andystopford/GPS_Tracker/Case/case_LiPo.dxf

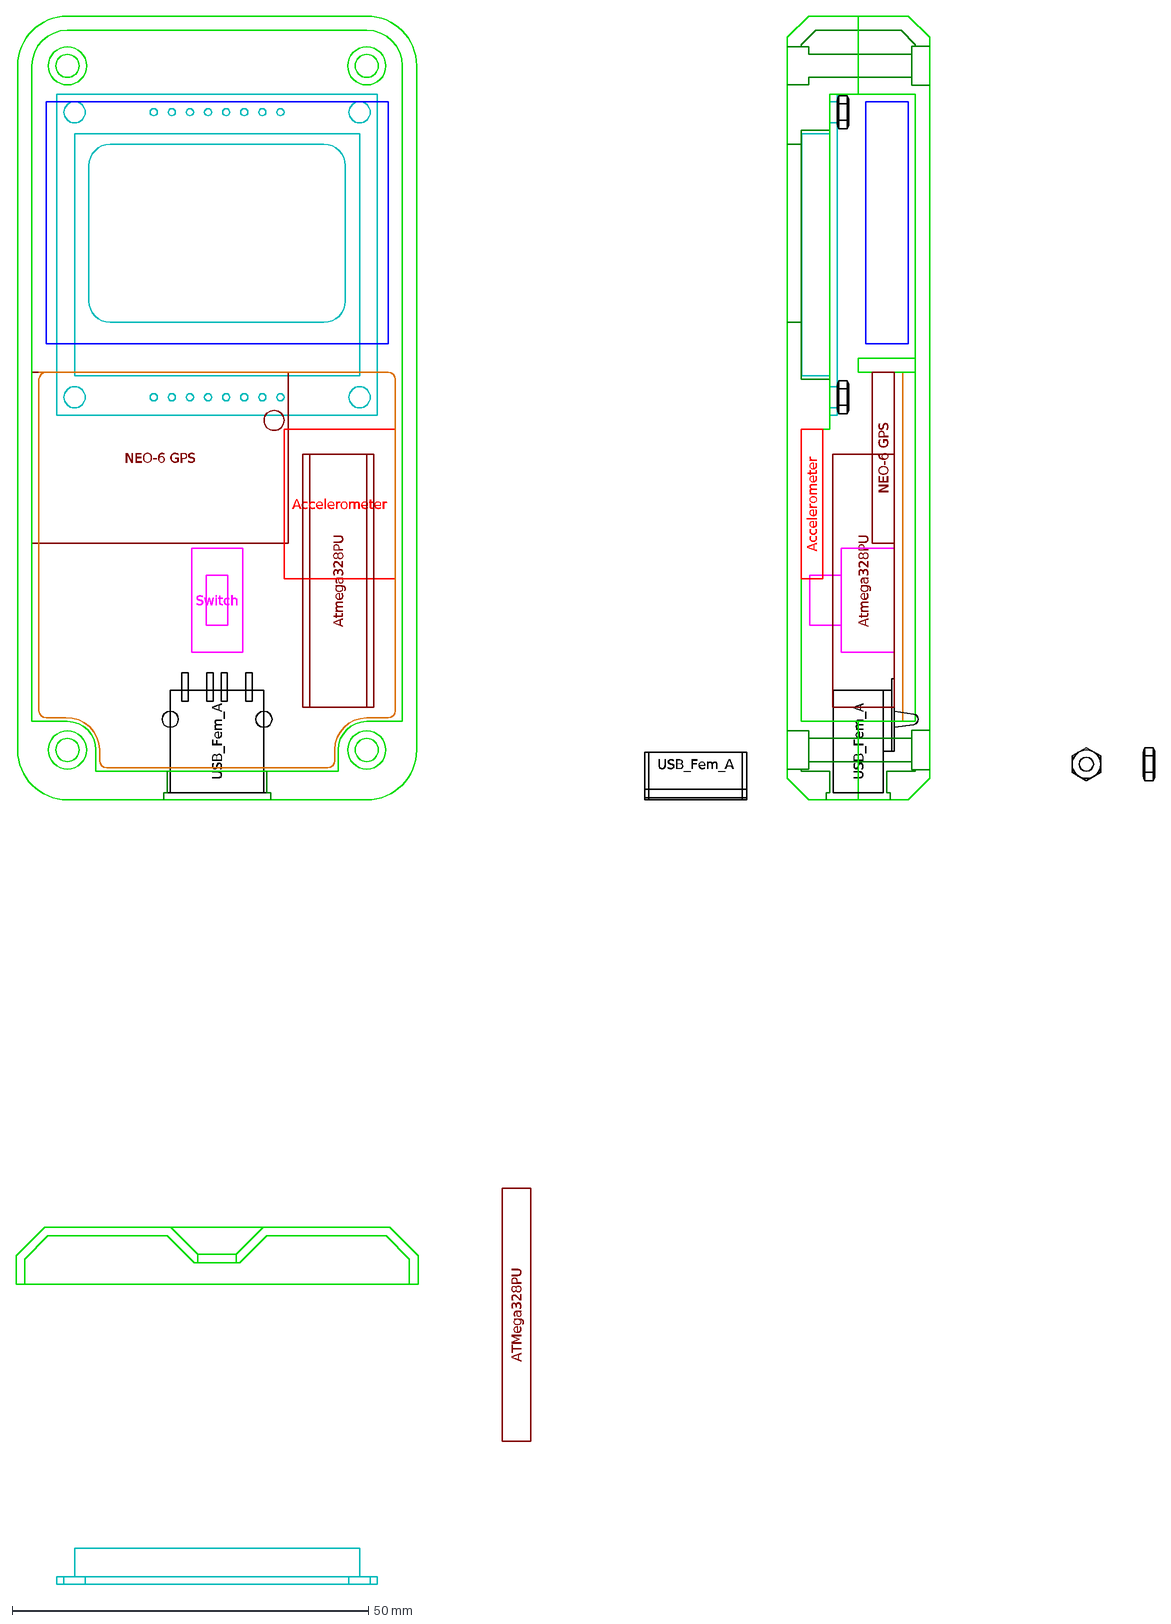
[picture p1: CAD file, 2018-06-07]
Case/case_LiPo.dxf
Atmega328PU
NEO-6 GPS
Switch
Accelerometer
ATMega328PU
USB_Fem_A
