andystopford/GPS_Tracker/PCB/Footprint_dwgs/16-LGA_3.25x3.0.dxf

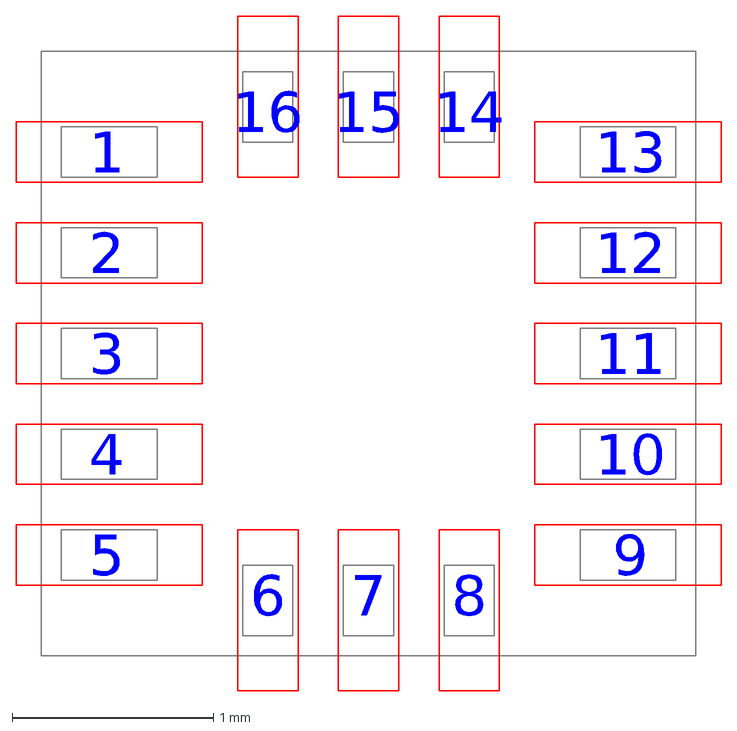
[picture p2: CAD file, 2018-06-07]
PCB/Footprint_dwgs/16-LGA_3.25x3.0.dxf
1
2
3
4
5
6
7
8
9
10
11
12
13
14
15
16
