andystopford/GPS_Tracker/PCB/PCB.dxf

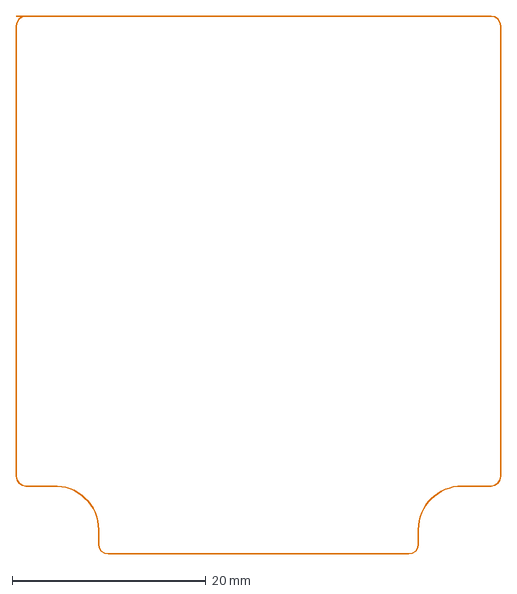
[picture p3: CAD file, 2018-06-07]
PCB/PCB.dxf
50.0 x 55.5 mm
