andystopford/GPS_Tracker/Case/GPS_tracker_support.stl

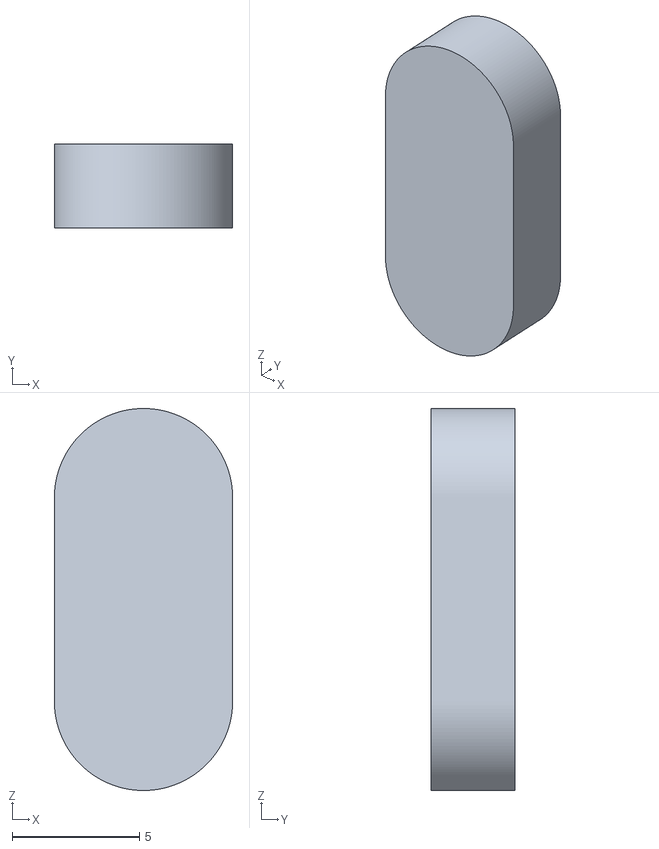
[picture p4: CAD file, 2018-06-07]
Case/GPS_tracker_support.stl
7.00 x 3.30 x 15.0
