andystopford/GPS_Tracker/Case/GPS_packing.stl

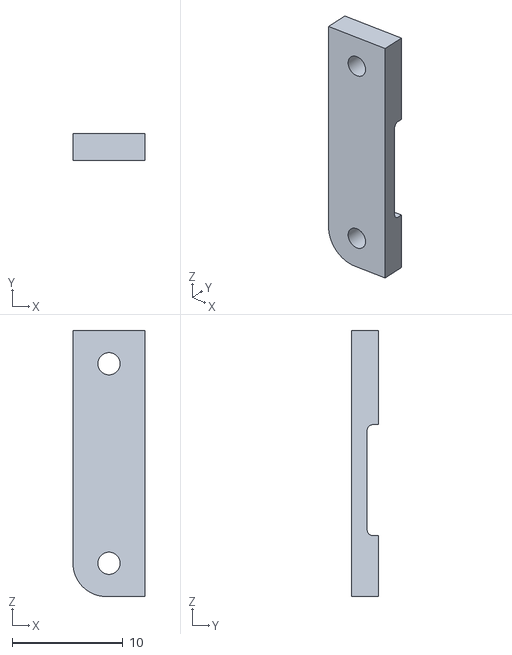
[picture p5: CAD file, 2018-06-07]
Case/GPS_packing.stl
6.50 x 2.40 x 24.0
