andystopford/GPS_Tracker/Case/case.dxf

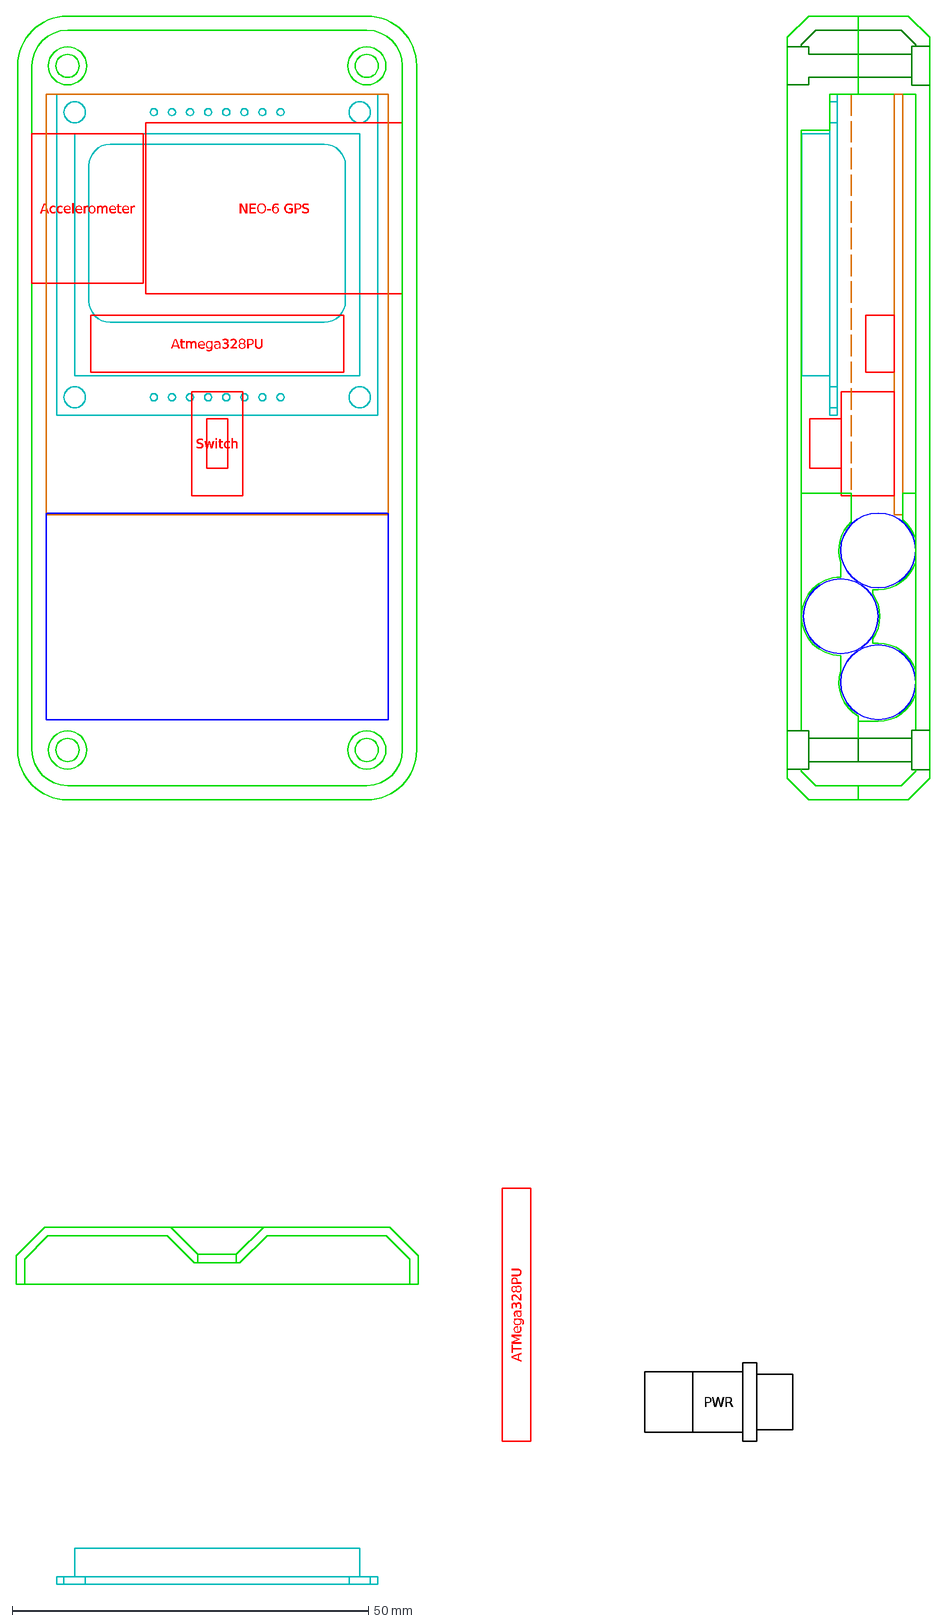
[picture p6: CAD file, 2018-06-07]
Case/case.dxf
Atmega328PU
NEO-6 GPS
Switch
Accelerometer
ATMega328PU
PWR
