andystopford/GPS_Tracker/Case/GPS_tracker_base.stl

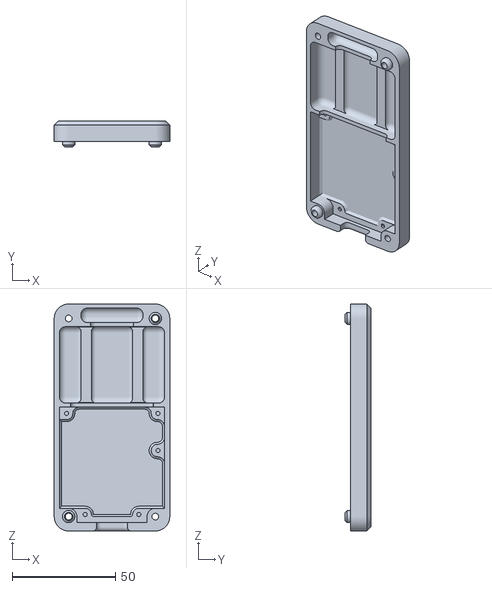
[picture p7: CAD file, 2018-06-07]
Case/GPS_tracker_base.stl
56.0 x 12.5 x 110.0
