andystopford/GPS_Tracker/Case/case_noLCD.dxf

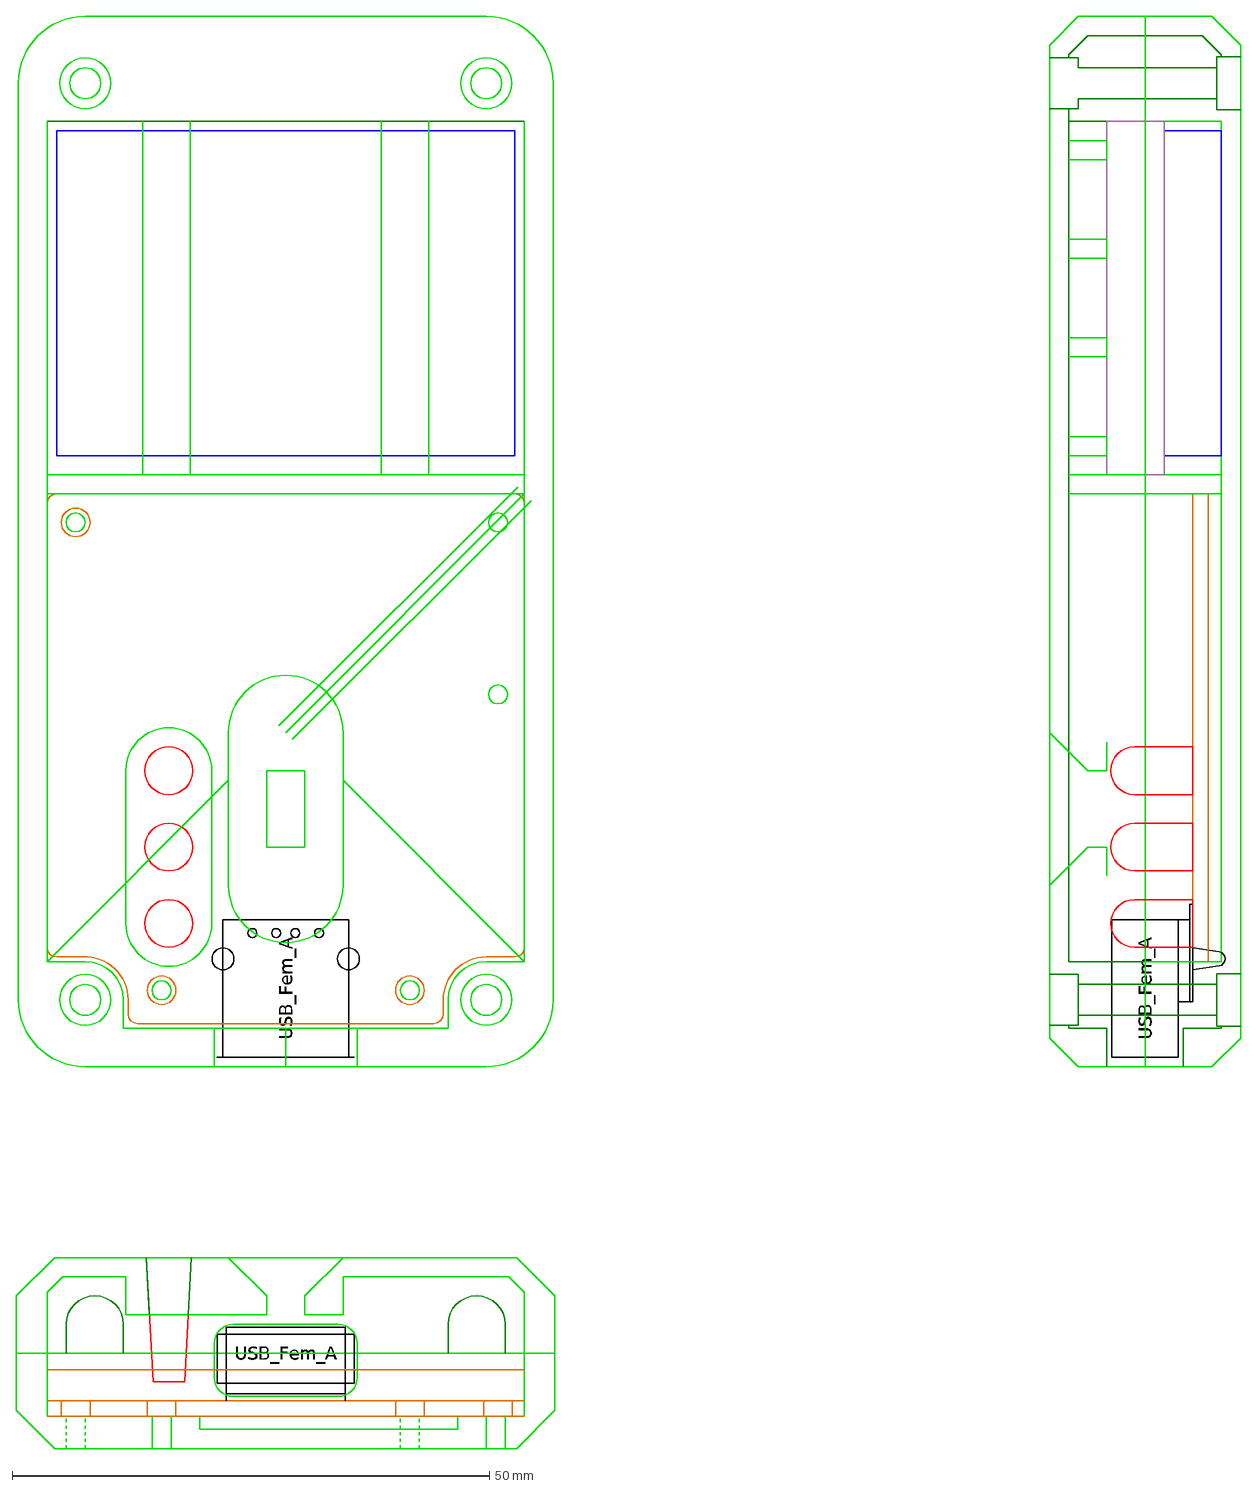
[picture p8: CAD file, 2018-06-07]
Case/case_noLCD.dxf
USB_Fem_A
