andystopford/GPS_Tracker/Case/GPS_tracker_top.stl

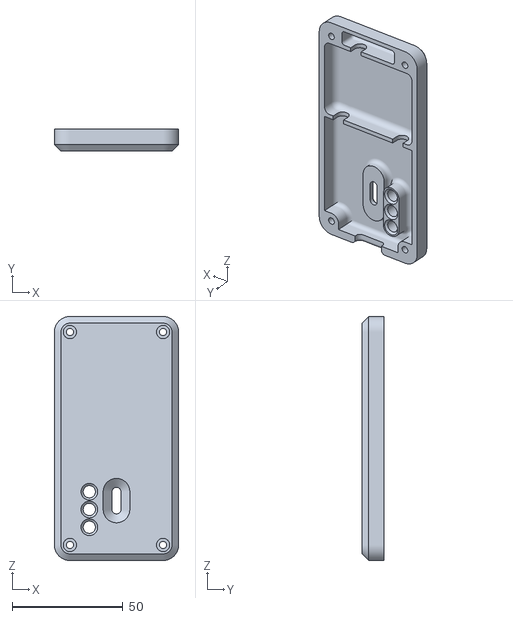
[picture p9: CAD file, 2018-02-08]
Case/GPS_tracker_top.stl
56.0 x 10.0 x 110.0
