andystopford/GPS_Tracker/(list of files, drawings)

Other design files:
PCB/AutoRouting/GPS_tracker_PCB.dsn
