andystopford/GPS_Tracker/PCB/GPS_tracker_PCB.kicad_pcb

## KiCad design PCB/GPS_tracker_PCB.kicad_pcb (2018-06-07)

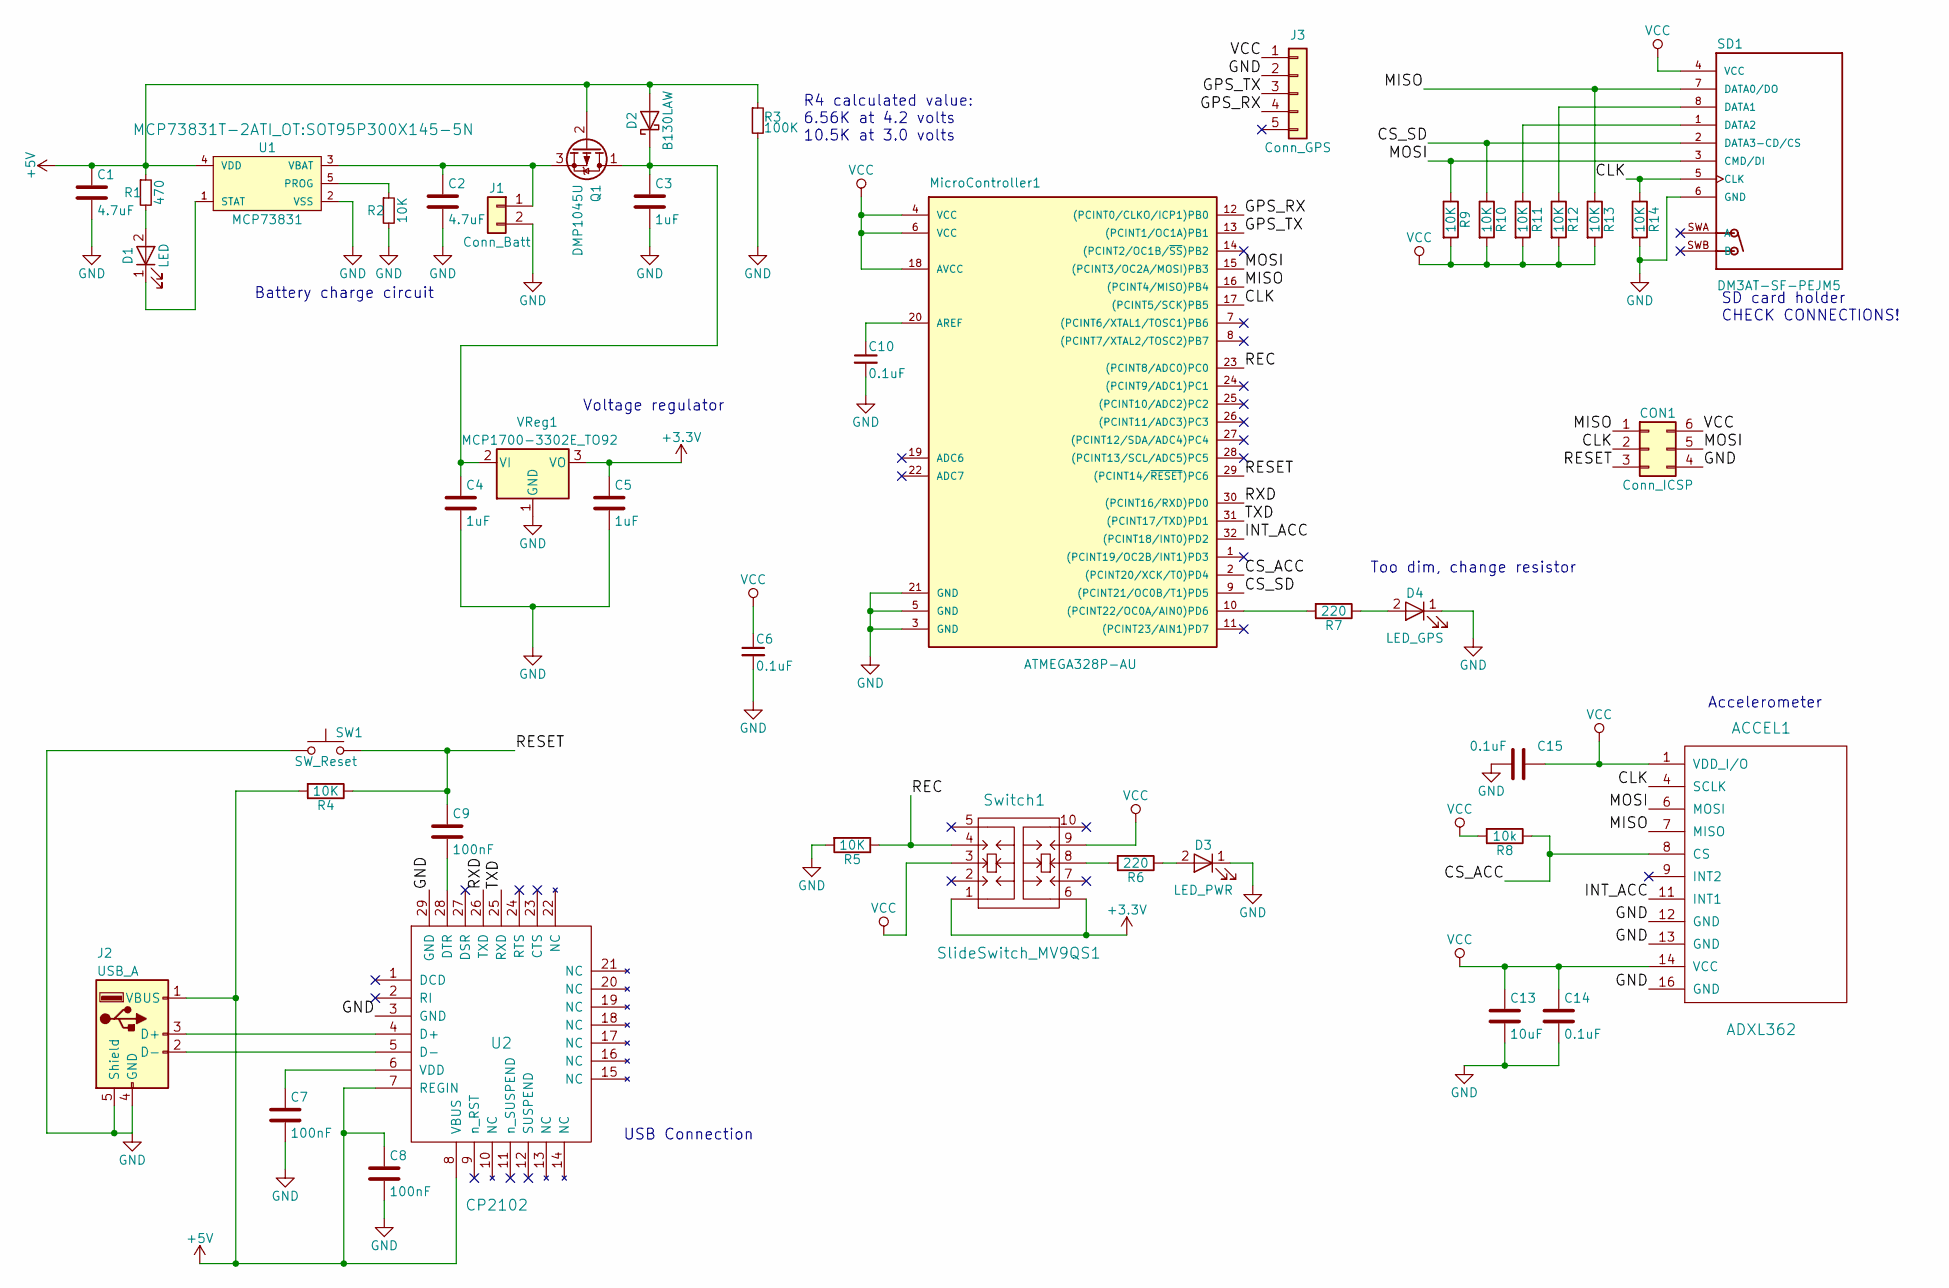
[picture p10: schematic GPS_tracker_PCB.sch]

Parts:
ACCEL1: ADXL362; LGA-16_3.25x3.00
C1, C2: 4.7uF; C_1206
C3, C4, C5: 1uF; C_1206
C6, C10, C14, C15: 0.1uF; C_1206
C7, C8, C9: 100nF; C_1206
C13: 10uF; C_1206
CON1: Conn_ICSP; Pin_Header_Straight_2x03_Pitch2.54mm
D1: LED; D_0603
D2: B130LAW; D_SOD-123
D3: LED_PWR; D_0603
D4: LED_GPS; D_0603
J1: Conn_Batt; Pin_Header_Straight_1x02_Pitch2.54mm
J2: USB_A
J3: Conn_GPS; Pin_Header_Straight_1x05_Pitch2.54mm
MicroController1: ATMEGA328P-AU; TQFP-32_7x7mm_Pitch0.8mm
Q1: DMP1045U
R1: 470; R_1206
R2, R4, R5, R9, R10, R11, R12, R13, R14: 10K; R_1206
R3: 100K; R_1206
R6, R7: 220; R_1206
R8: 10k; R_1206
SD1: DM3AT-SF-PEJM5; HRS_DM3AT-SF-PEJM5
SW1: SW_Reset; TactileButton_2Pin
Switch1: SlideSwitch_MV9QS1
U1: MCP73831; SOT95P300X145-5N
U2: CP2102; QFN-28-1EP_5x5mm_Pitch0.5mm
VReg1: MCP1700-3302E_TO92; TO-92_Inline_Wide

Connections:
+3V3: C5.1, Switch1.1, Switch1.6, VReg1.3 (VO)
+5V: C1.1, C8.1, D2.2 (A), J2.1 (VBUS), Q1.2 (G), R1.1, R3.1, R4.2, U1.4 (VDD), U2.7 (REGIN), U2.8 (VBUS)
/CLK: ACCEL1.4 (SCLK), CON1.2, MicroController1.17 ((PCINT5/SCK)PB5), R14.1, SD1.5 (CLK)
/CS_ACC: ACCEL1.8 (CS), MicroController1.2 ((PCINT20/XCK/T0)PD4), R8.1
/CS_SD: MicroController1.9 ((PCINT21/OC0B/T1)PD5), R10.1, SD1.2 (DATA3-CD/CS)
/GPS_RX: J3.4, MicroController1.12 ((PCINT0/CLKO/ICP1)PB0)
/GPS_TX: J3.3, MicroController1.13 ((PCINT1/OC1A)PB1)
/INT_ACC: ACCEL1.11 (INT1), MicroController1.32 ((PCINT18/INT0)PD2)
/MISO: ACCEL1.7 (MISO), CON1.1, MicroController1.16 ((PCINT4/MISO)PB4), R13.1, SD1.7 (DATA0/DO)
/MOSI: ACCEL1.6 (MOSI), CON1.5, MicroController1.15 ((PCINT3/OC2A/MOSI)PB3), R9.1, SD1.3 (CMD/DI)
/REC: MicroController1.23 ((PCINT8/ADC0)PC0), R5.1, Switch1.4
/RESET: C9.1, CON1.3, MicroController1.29 ((PCINT14/~RESET~)PC6), R4.1, SW1.2
/RXD: MicroController1.30 ((PCINT16/RXD)PD0), U2.26 (TXD)
/TXD: MicroController1.31 ((PCINT17/TXD)PD1), U2.25 (RXD)
GND: ACCEL1.12 (GND), ACCEL1.13 (GND), ACCEL1.16 (GND), C1.2, C2.2, C3.2, C4.2, C5.2, C6.2, C7.2, C8.2, C10.2, C13.2, C14.2, C15.2, CON1.4, D3.1 (K), D4.1 (K), J1.2, J2.4 (GND), J2.5 (Shield), J3.2, MicroController1.3 (GND), MicroController1.5 (GND), MicroController1.21 (GND), R2.2, R3.2, R5.2, R14.2, SD1.6 (GND), SW1.1, U1.2 (VSS), U2.3 (GND), U2.29 (GND), VReg1.1 (GND)
unnamed: C2.1, J1.1, Q1.3 (S), U1.3 (VBAT)
unnamed: C3.1, C4.1, D2.1 (K), Q1.1 (D), VReg1.2 (VI)
unnamed: C7.1, U2.6 (VDD)
unnamed: C9.2, U2.28 (DTR)
unnamed: C10.1, MicroController1.20 (AREF)
unnamed: D1.1 (K), U1.1 (STAT)
unnamed: D1.2 (A), R1.2
unnamed: D3.2 (A), R6.1
unnamed: D4.2 (A), R7.1
unnamed: J2.2 (D-), U2.5 (D-)
unnamed: J2.3 (D+), U2.4 (D+)
unnamed: MicroController1.10 ((PCINT22/OC0A/AIN0)PD6), R7.2
unnamed: R2.1, U1.5 (PROG)
unnamed: R6.2, Switch1.8
unnamed: R11.1, SD1.1 (DATA2)
unnamed: R12.1, SD1.8 (DATA1)
VCC: ACCEL1.1 (VDD_I/O), ACCEL1.14 (VCC), C6.1, C13.1, C14.1, C15.1, CON1.6, J3.1, MicroController1.4 (VCC), MicroController1.6 (VCC), MicroController1.18 (AVCC), R8.2, R9.2, R10.2, R11.2, R12.2, R13.2, SD1.4 (VCC), Switch1.3, Switch1.9

Notes on the sheet:
USB Connection
SD card holder CHECK CONNECTIONS!
Battery charge circuit
Voltage regulator
R4 calculated value: 6.56K at 4.2 volts 10.5K at 3.0 volts
Accelerometer
Too dim, change resistor

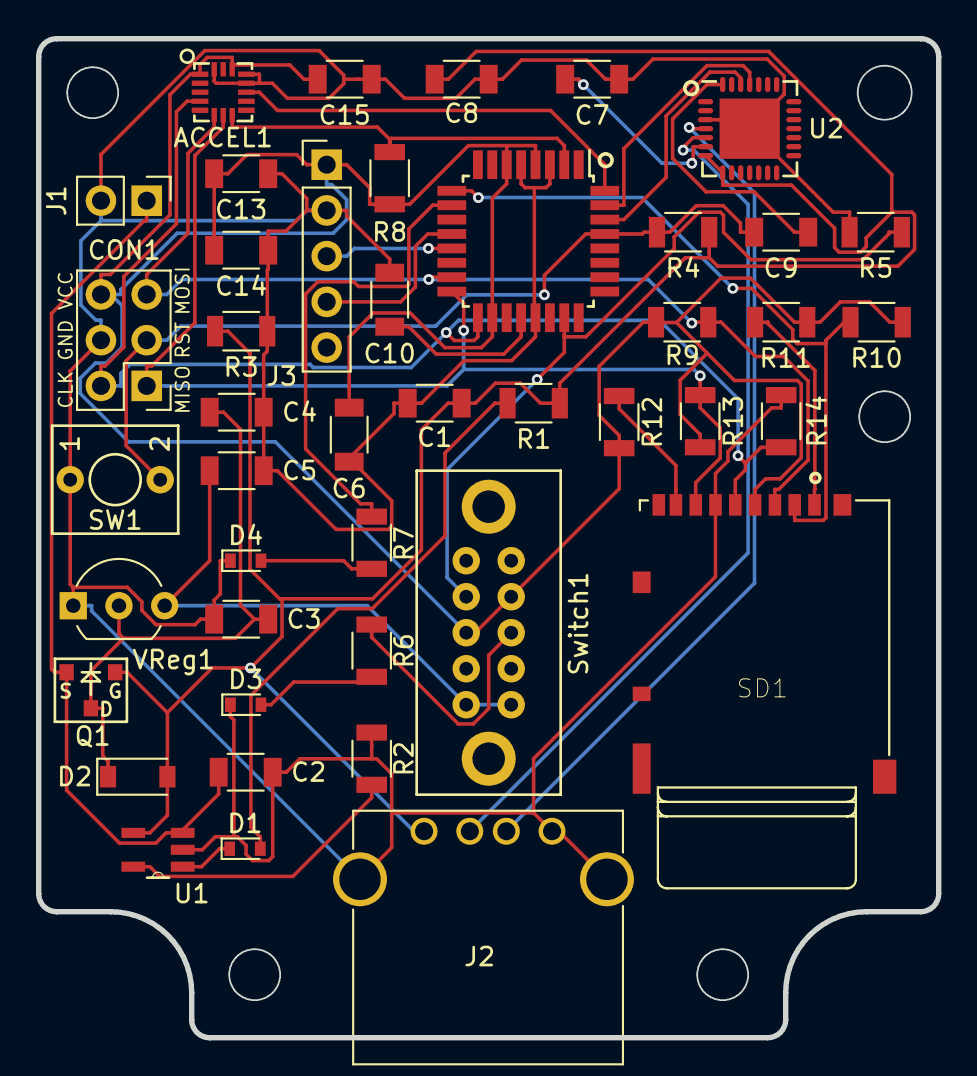
[picture p11: board GPS_tracker_PCB.kicad_pcb from above]

Board: 2 copper layers, 50.0 x 55.5 mm, 44 parts (0 on the bottom side), 32 nets.
