andystopford/GPS_Tracker/PCB/BAK.kicad_pcb

## KiCad design PCB/BAK.kicad_pcb (2018-06-07)

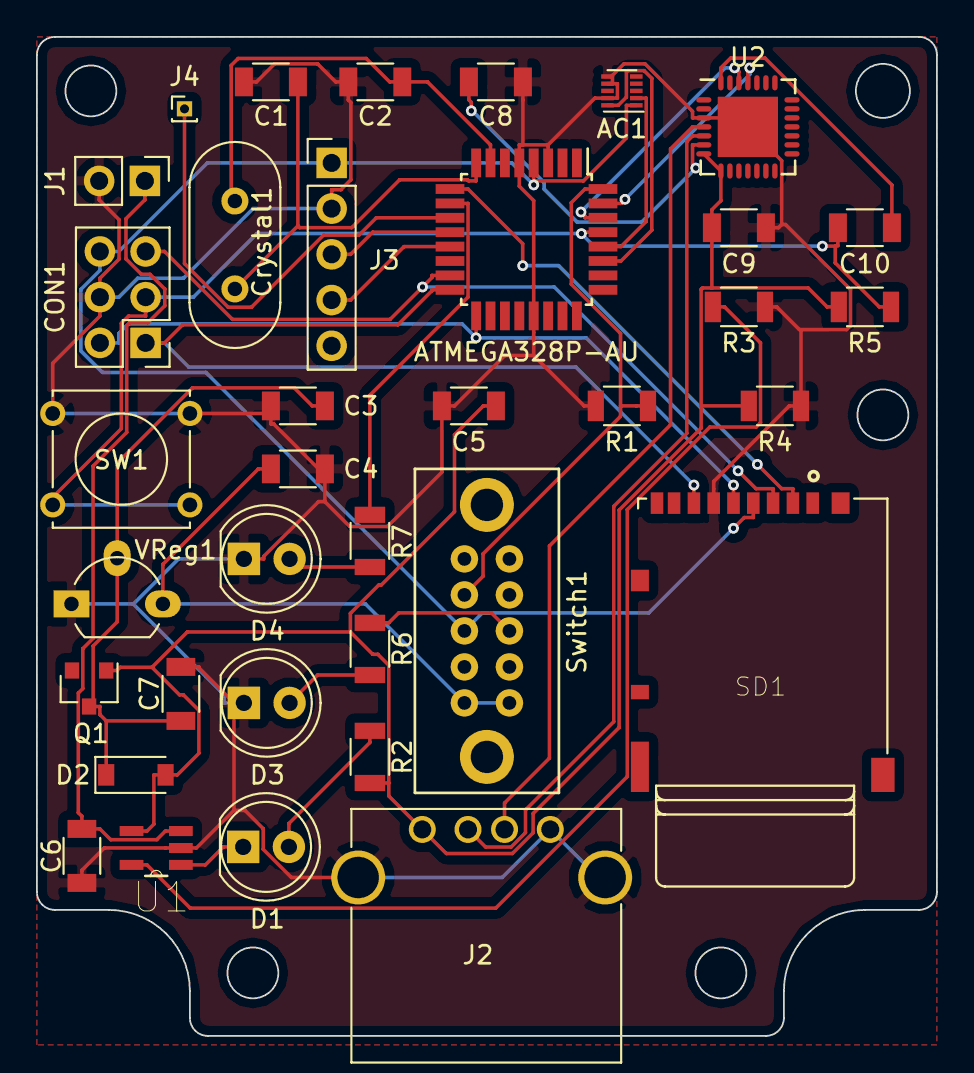
[picture p12: board BAK.kicad_pcb from above]

Board: 2 copper layers, 50.0 x 55.5 mm, 36 parts (0 on the bottom side), 32 nets.

Parts:
AC1: MMA8652FCR1; DFN-10_2x2mm_Pitch0.4mm
C1, C2, C3, C4: C; C_1206
C5, C6: 4uF; C_1206
C7: 1uF; C_1206
C8, C9, C10: 100nF; C_1206
CON1: Conn_ICSP; Pin_Header_Straight_2x03_Pitch2.54mm
Crystal1: 8MHz; Crystal_HC49-4H_Vertical
D1: LED; LED_D5.0mm
D2: B130LAW; D_SOD-123
D3: LED_PWR; LED_D5.0mm
D4: LED_GPS; LED_D5.0mm
J1: Conn_Batt; Pin_Header_Straight_1x02_Pitch2.54mm
J2: USB_A
J3: Conn_GPS; Pin_Header_Straight_1x05_Pitch2.54mm
J4: Conn_GPS_LED; Pin_Header_Straight_1x01_Pitch1.00mm
MicroController2: ATMEGA328P-AU; TQFP-32_7x7mm_Pitch0.8mm
Q1: DMP1045U; D_SOT-23_ANK
R1, R3, R5: 10K; R_1206
R2: 470; R_1206
R4: 100K; R_1206
R6, R7: 220; R_1206
SD1: DM3AT-SF-PEJM5; HRS_DM3AT-SF-PEJM5
SW1: SW_Reset; SW_Tactile_Straight_KSA0Axx1LFTR
Switch1: SlideSwitch_MV9QS1
U1: MCP73831; SOT95P300X145-5N
U2: CP2102; QFN-28-1EP_5x5mm_Pitch0.5mm
VReg1: MCP1700-3302E_TO92; TO-92_Molded_Wide_Oval

Connections:
+3V3: C4.1, Switch1.1, Switch1.6, VReg1.3
+5V: C5.1, C9.1, D2.2, J2.1, Q1.2, R2.1, R4.1, R5.2, U1.4, U2.7, U2.8
/CLK: CON1.2, MicroController2.17, SD1.5
/CS_SD: MicroController2.9, SD1.2
/GPS_RX: J3.4, MicroController2.13
/GPS_TX: J3.3, MicroController2.12
/MISO: CON1.1, MicroController2.16, SD1.7
/MOSI: CON1.5, MicroController2.15, SD1.3
/REC: MicroController2.32, R1.1, Switch1.4
/RESET: C10.1, CON1.3, MicroController2.29, R5.1, SW1.2
/RXD: MicroController2.30, U2.26
/SCL: AC1.2, MicroController2.28
/SDA: AC1.10, MicroController2.27
/TXD: MicroController2.31, U2.25
/VCC: AC1.1, CON1.6, J3.1, MicroController2.4, SD1.4, Switch1.3
GND: AC1.6, AC1.7, AC1.9, C1.2, C2.2, C3.2, C4.2, C5.2, C6.2, C7.2, C8.2, C9.2, CON1.4, D3.1, D4.1, J1.2, J2.4, J2.5, J3.2, MicroController2.3, MicroController2.5, MicroController2.21, R1.2, R3.2, R4.2, SD1.6, SW1.1, U1.2, U2.3, U2.29, VReg1.1
unnamed: C1.1, Crystal1.1, MicroController2.8
unnamed: C2.1, Crystal1.2, MicroController2.7
unnamed: C3.1, C7.1, D2.1, Q1.1, VReg1.2
unnamed: C6.1, J1.1, U1.3
unnamed: C8.1, U2.6
unnamed: C10.2, U2.28
unnamed: D1.1, U1.1
unnamed: D1.2, R2.2
unnamed: D3.2, R6.1
unnamed: D4.2, R7.1
unnamed: J2.2, U2.5
unnamed: J2.3, U2.4
unnamed: J4.1, MicroController2.11
unnamed: MicroController2.10, R7.2
unnamed: R3.1, U1.5
unnamed: R6.2, Switch1.8
