andystopford/GPS_Tracker/(commit log)

2018-02-08 Initial commit.
    [GPS_tracker_PCB-B.Cu.gbl, GPS_tracker_PCB-B.Mask.gbs, GPS_tracker_PCB-B.Paste.gbp, GPS_tracker_PCB-B.SilkS.gbo, GPS_tracker_PCB-Edge.Cuts.gm1, GPS_tracker_PCB-F.Cu.gtl, GPS_tracker_PCB-F.Mask.gts, GPS_tracker_PCB-F.Paste.gtp]
2018-06-07 Current working version, most junk cleared out.
    [GPS_tracker_PCB.dsn, GPS_tracker_PCB.kicad_pcb, GPS_tracker_PCB.sch, GPS_tracker_base.stl, case_noLCD.dxf]
2018-06-07 Current version
    [16-LGA_3.25x3.0.dxf, BAK.kicad_pcb, GPS_packing.stl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]
